CohenMurray/SRAD-Telemetry-PCB/PCB/Telemetry PCB V2/JLCPCB-order-config.png

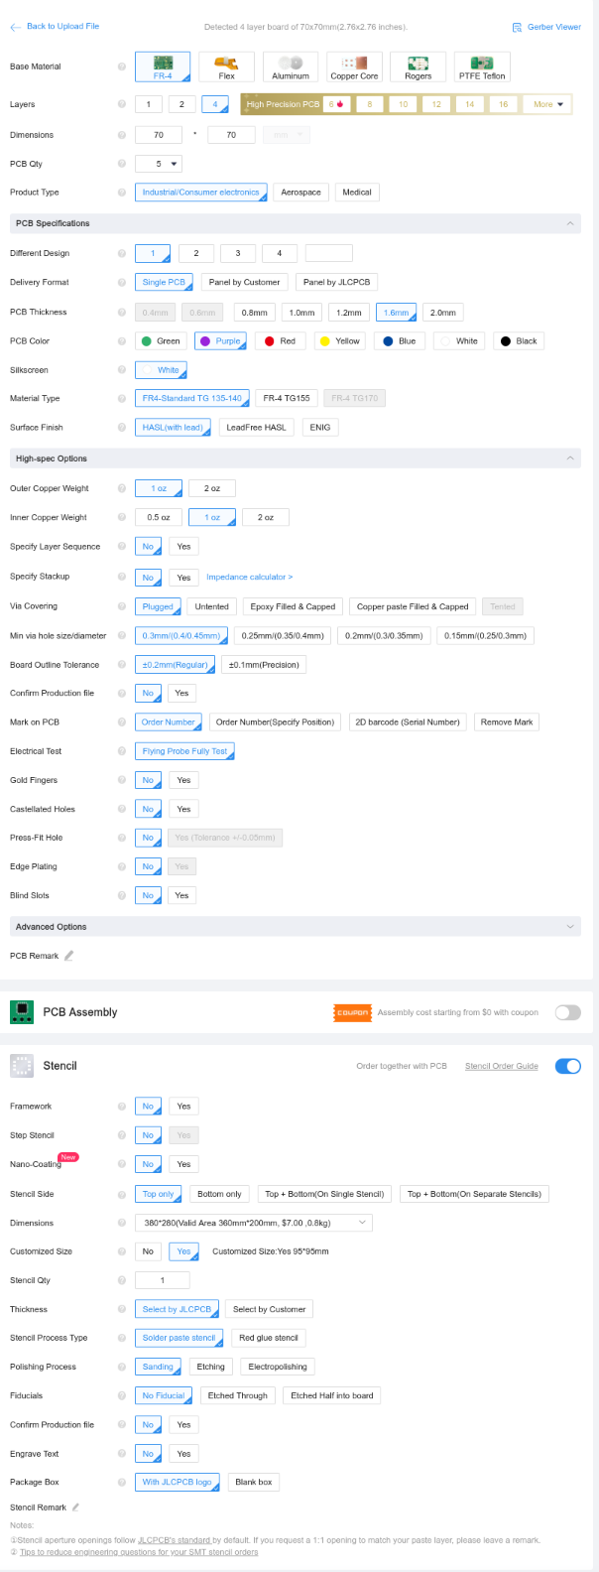
PCB/Telemetry PCB V2/JLCPCB-order-config.png
