CohenMurray/SRAD-Telemetry-PCB/KiCad Libraries/E22-900M30S/E22-900M30S.step

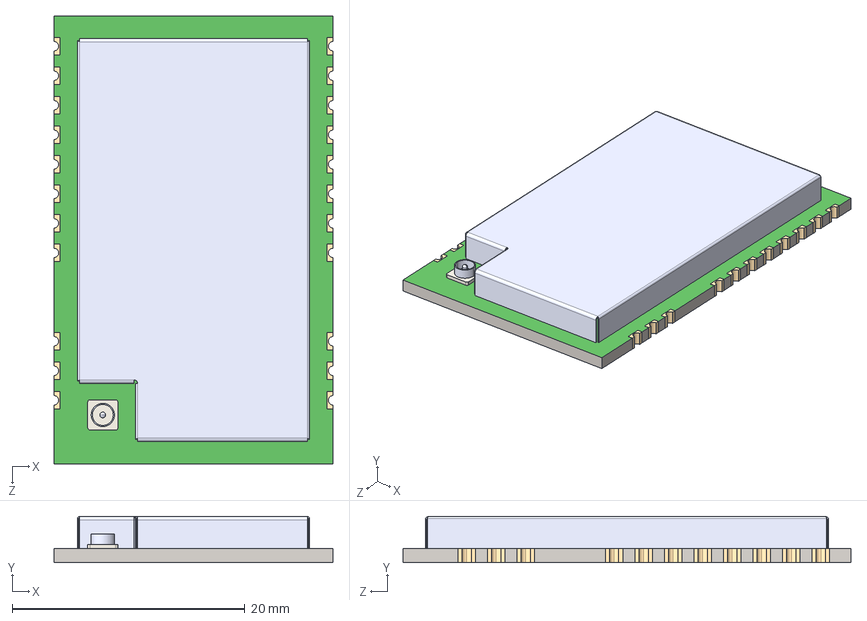
[picture p2: CAD file, 2024-10-28]
KiCad Libraries/E22-900M30S/E22-900M30S.step
24.0 x 3.97 x 38.5 mm
