CohenMurray/SRAD-Telemetry-PCB/KiCad Libraries/E22-900M33S/E22-900M22S.step

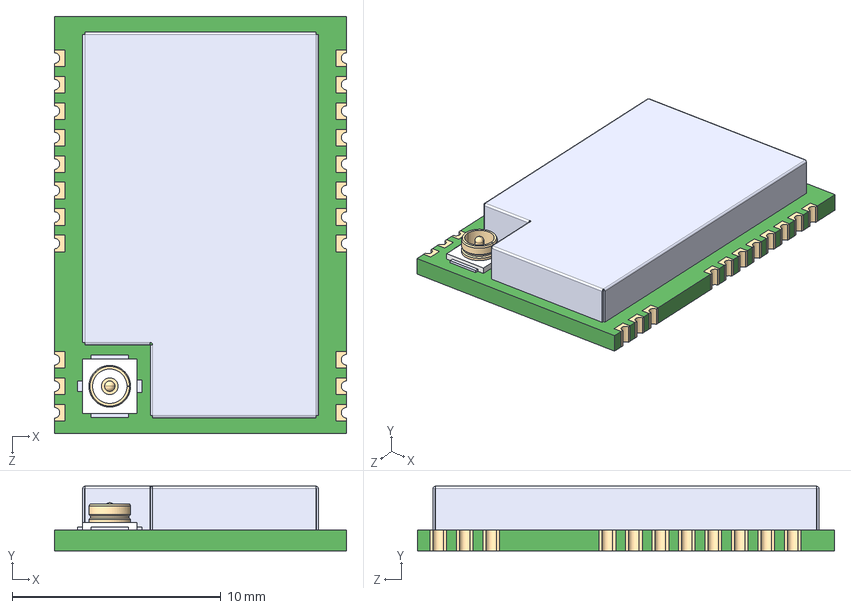
[picture p3: CAD file, 2024-10-25]
KiCad Libraries/E22-900M33S/E22-900M22S.step
14.0 x 3.10 x 20.0 mm
