CohenMurray/SRAD-Telemetry-PCB/KiCad Libraries/ECS_250_10_30B_CKM_TR/ECS-250-10-30B-CKM-TR.step

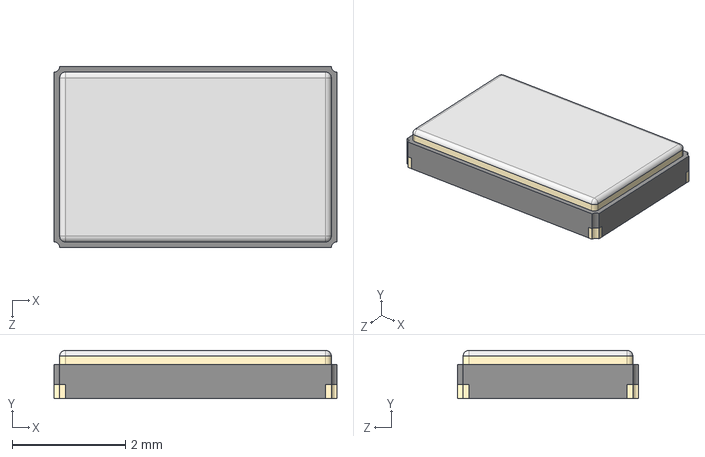
[picture p4: CAD file, 2024-11-11]
KiCad Libraries/ECS_250_10_30B_CKM_TR/ECS-250-10-30B-CKM-TR.step
5.00 x 0.85 x 3.20 mm
