CohenMurray/SRAD-Telemetry-PCB/KiCad Libraries/ECS__327_12_5_34RR_TR/ECS-.327-12.5-34RR-TR.step

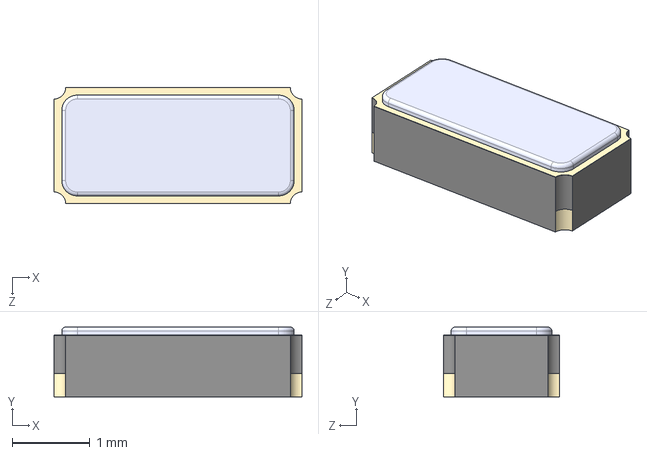
[picture p5: CAD file, 2024-11-11]
KiCad Libraries/ECS__327_12_5_34RR_TR/ECS-.327-12.5-34RR-TR.step
3.20 x 0.9 x 1.50 mm
