CohenMurray/SRAD-Telemetry-PCB/KiCad Libraries/LQH3NPN2R2MMEL/LQH3NPN2R2MMEL.step

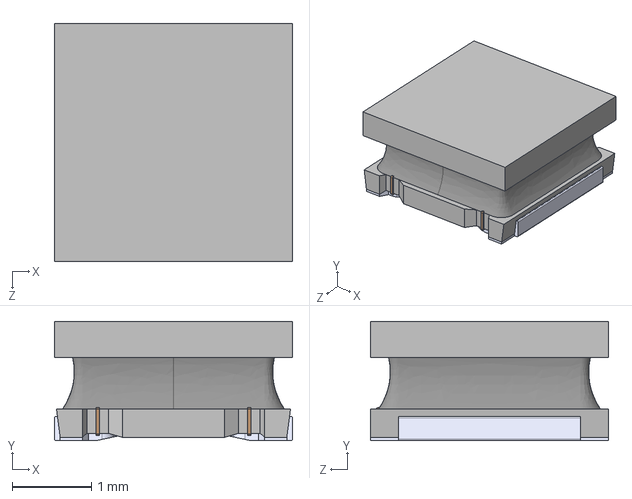
[picture p6: CAD file, 2025-09-01]
KiCad Libraries/LQH3NPN2R2MMEL/LQH3NPN2R2MMEL.step
3.00 x 1.50 x 3.00 mm
