CohenMurray/SRAD-Telemetry-PCB/PCB/Sending Pebble/Sending Pebble/Sending Pebble.kicad_pcb

## KiCad design PCB/Sending Pebble/Sending Pebble/Sending Pebble.kicad_pcb (2025-10-25)

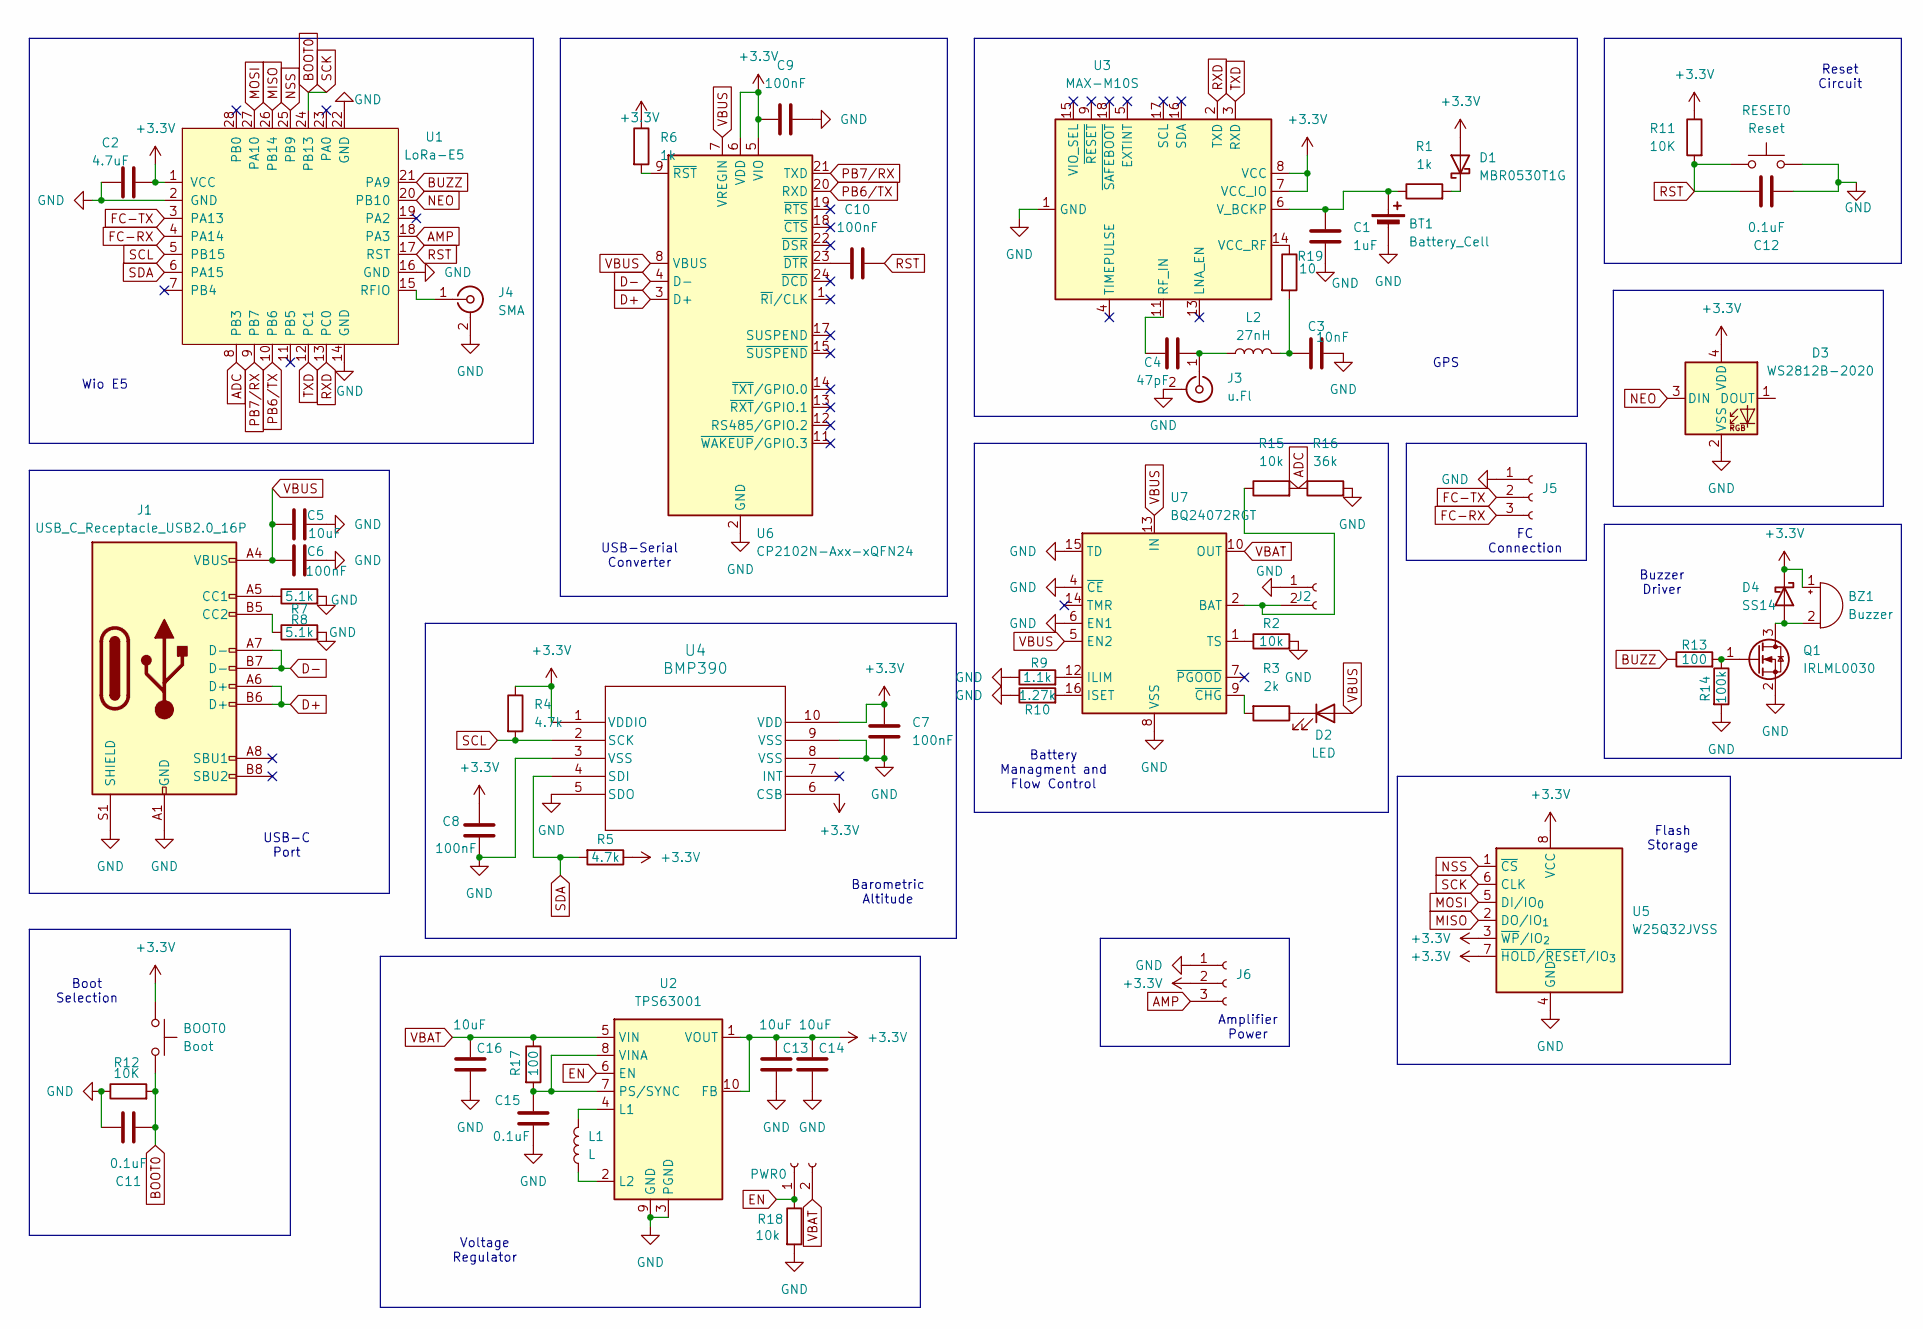
[picture p7: schematic Sending Pebble.kicad_sch, Sending Pebble v1]

Parts:
BOOT0: Boot; SW_SPST_PTS810
BT1: Battery_Cell; BatteryHolder_Seiko_MS621F
BZ1: Buzzer; MagneticBuzzer_PUI_SMT-1028-T-2-R
C1: 1uF; C_0603_1608Metric
C2: 4.7uF; C_0603_1608Metric
C3: 10nF; C_0402_1005Metric
C4: 47pF; C_0402_1005Metric
C5, C13, C14, C16: 10uF; C_0603_1608Metric
C6, C7, C8, C9, C10: 100nF; C_0603_1608Metric
C11, C12, C15: 0.1uF; C_0603_1608Metric
D1: MBR0530T1G; D_SOD-123
D2: LED; LED_0603_1608Metric
D3: WS2812B-2020; LED_WS2812B-2020_PLCC4_2.0x2.0mm
D4: SS14; D_SMA
J1: USB_C_Receptacle_USB2.0_16P; USB_C_Receptacle_HCTL_HC-TYPE-C-16P-01A
J2: Conn_01x02_Socket; JST_PH_S2B-PH-SM4-TB_1x02-1MP_P2.00mm_Horizontal
J3: u.Fl; U.FL_Hirose_U.FL-R-SMT-1_Vertical
J4: SMA; SMA_Amphenol_132289_EdgeMount
J5: Conn_01x03_Socket; JST_XH_B3B-XH-AM_1x03_P2.50mm_Vertical
J6: Conn_01x03_Socket; PinHeader_1x03_P2.54mm_Vertical
L1: L; IND_LQH3NPN2R2MMEL
L2: 27nH; C_0402_1005Metric
PWR0: Conn_01x02_Socket; PinSocket_1x02_P2.54mm_Vertical
Q1: IRLML0030; SOT-23
R1, R6: 1k; R_0603_1608Metric
R2, R15, R18: 10k; R_0603_1608Metric
R3: 2k; R_0603_1608Metric
R4, R5: 4.7k; R_0603_1608Metric
R7, R8: 5.1k; R_0603_1608Metric
R9: 1.1k; R_0603_1608Metric
R10: 1.27k; R_0603_1608Metric
R11, R12: 10K; R_0603_1608Metric
R13, R17: 100; R_0603_1608Metric
R14: 100k; R_0603_1608Metric
R16: 36k; R_0603_1608Metric
R19: 10; C_0402_1005Metric
RESET0: Reset; SW_SPST_PTS810
U1: LoRa-E5
U2: TPS63001; Texas_DRC0010J_ThermalVias
U3: MAX-M10S; ublox_MAX
U4: BMP390; 10LGA_2X2X0p75_BOS
U5: W25Q32JVSS; SOIC-8_5.3x5.3mm_P1.27mm
U6: CP2102N-Axx-xQFN24; QFN-24-1EP_4x4mm_P0.5mm_EP2.6x2.6mm
U7: BQ24072RGT; VQFN-16-1EP_3x3mm_P0.5mm_EP1.6x1.6mm

Connections:
+3.3V: BOOT0.1, BZ1.1 (+), C2.2, C7.1, C8.1, C9.1, C13.1, C14.1, D1.2 (A), D3.4 (VDD), D4.1 (K), J6.2, R4.1, R5.1, R6.1, R11.1, U1.1 (VCC), U2.1 (VOUT), U2.10 (FB), U3.7 (VCC_IO), U3.8 (VCC), U4.1 (VDDIO), U4.6 (CSB), U4.10 (VDD), U5.3 (~WP/IO_{2}), U5.7 (~HOLD/~RESET/IO_{3}), U5.8 (VCC), U6.5 (VIO), U6.6 (VDD)
ADC: R15.2, R16.1, U1.8 (PB3)
AMP: J6.3, U1.18 (PA3)
BOOT0: BOOT0.2, C11.2, R12.2, U1.24 (PB13~), U5.6 (CLK)
BUZZ: R13.1, U1.21 (PA9)
D+: J1.A6 (D+), J1.B6 (D+), U6.3 (D+)
D-: J1.A7 (D-), J1.B7 (D-), U6.4 (D-)
EN: PWR0.1, R18.1, U2.6 (EN)
FC-RX: J5.3, U1.4 (PA14)
FC-TX: J5.2, U1.3 (PA13)
GND: BT1.2 (-), C1.2, C2.1, C3.2, C5.2, C6.2, C7.2, C8.2, C9.2, C11.1, C12.2, C13.2, C14.2, C15.2, C16.2, D3.2 (VSS), J1.A1 (GND), J1.A12 (GND), J1.B1 (GND), J1.B12 (GND), J1.S1 (SHIELD), J2.1, J3.2 (Ext), J4.2 (Ext), J5.1, J6.1, Q1.2 (S), R2.2, R7.2, R8.2, R9.1, R10.1, R12.1, R14.2, R16.2, R18.2, RESET0.2, U1.2 (GND), U1.14 (GND), U1.16 (GND), U1.22 (GND), U2.3 (PGND), U2.9 (GND), U2.11 (PGND), U3.1 (GND), U3.10 (GND), U3.12 (GND), U4.3 (VSS), U4.5 (SDO), U4.8 (VSS), U4.9 (VSS), U5.4 (GND), U6.2 (GND), U6.25 (GND), U7.4 (~CE), U7.6 (EN1), U7.8 (VSS), U7.15 (TD), U7.17 (VSS)
MISO: U1.26 (PB14), U5.2 (DO/IO_{1})
MOSI: U1.27 (PA10), U5.5 (DI/IO_{0})
NEO: D3.3 (DIN), U1.20 (PB10)
NSS: U1.25 (PB9), U5.1 (~CS)
unnamed: BT1.1 (+), C1.1, R1.1, U3.6 (V_BCKP)
unnamed: BZ1.2 (-), D4.2 (A), Q1.3 (D)
unnamed: C3.1, L2.2, R19.2
unnamed: D1.1 (K), R1.2
unnamed: D2.1 (K), R3.1
unnamed: J1.A5 (CC1), R7.1
unnamed: J1.B5 (CC2), R8.1
unnamed: J2.2, R15.1, U7.2 (BAT), U7.3 (BAT)
unnamed: C4.2, J3.1 (In), L2.1
unnamed: J4.1 (In), U1.15 (RFIO)
unnamed: Q1.1 (G), R13.2, R14.1
unnamed: L1.2, U2.4 (L1)
unnamed: L1.1, U2.2 (L2)
unnamed: C15.1, R17.2, U2.7 (PS/SYNC), U2.8 (VINA)
unnamed: C4.1, U3.11 (RF_IN)
unnamed: R19.1, U3.14 (VCC_RF)
unnamed: C10.1, U6.23 (~DTR)
unnamed: R6.2, U6.9 (~RST)
unnamed: R9.2, U7.12 (ILIM)
unnamed: R10.2, U7.16 (ISET)
unnamed: R2.1, U7.1 (TS)
unnamed: R3.2, U7.9 (~CHG)
PB6/TX: U1.10 (PB6), U6.20 (RXD)
PB7/RX: U1.9 (PB7), U6.21 (TXD)
RST: C10.2, C12.1, R11.2, RESET0.1, U1.17 (RST)
RXD: U1.13 (PC0), U3.2 (TXD)
SCL: R4.2, U1.5 (PB15), U4.2 (SCK)
SDA: R5.2, U1.6 (PA15), U4.4 (SDI)
TXD: U1.12 (PC1), U3.3 (RXD)
VBAT: C16.1, PWR0.2, R17.1, U2.5 (VIN), U7.10 (OUT), U7.11 (OUT)
VBUS: C5.1, C6.1, D2.2 (A), J1.A4 (VBUS), J1.A9 (VBUS), J1.B4 (VBUS), J1.B9 (VBUS), U6.7 (VREGIN), U6.8 (VBUS), U7.5 (EN2), U7.13 (IN)

Notes on the sheet:
GPS
FC Connection
Battery Managment and Flow Control
USB-C Port
Flash Storage
Amplifier Power
Voltage Regulator
USB-Serial Converter
Barometric Altitude
Reset Circuit
Buzzer Driver
Wio E5
Boot Selection

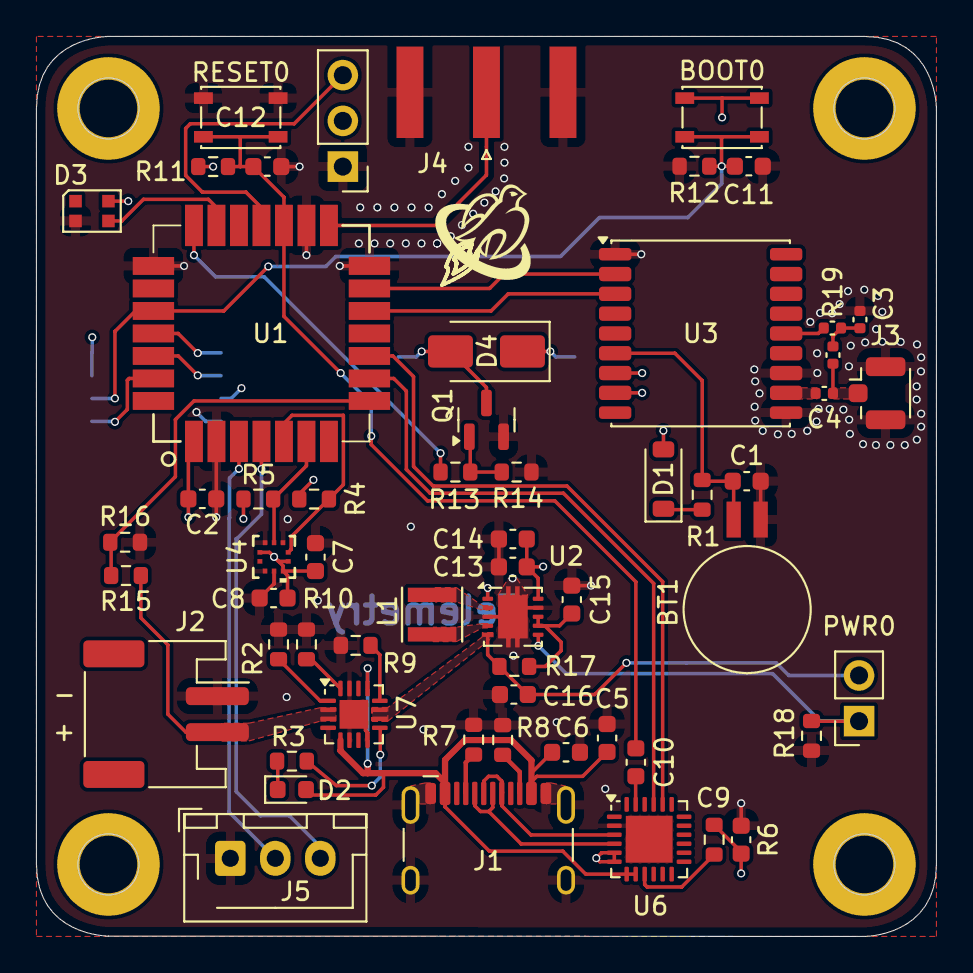
[picture p8: board Sending Pebble.kicad_pcb from above]

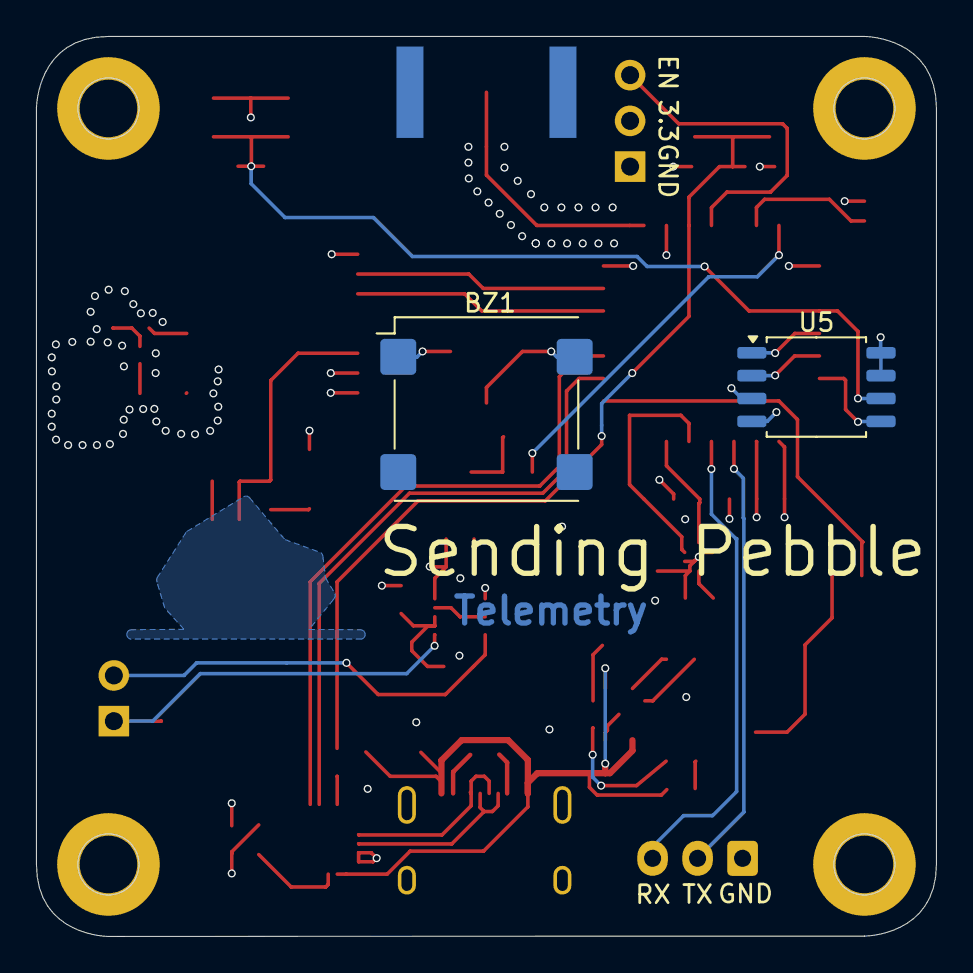
[picture p9: board Sending Pebble.kicad_pcb from below]

Board: 4 copper layers, 50.0 x 50.0 mm, 60 parts (2 on the bottom side), 46 nets.
