CohenMurray/SRAD-Telemetry-PCB/PCB/Telemetry PCB V2/Telemetry PCB V2.kicad_pcb

## KiCad design PCB/Telemetry PCB V2/Telemetry PCB V2.kicad_pcb (2025-07-25)

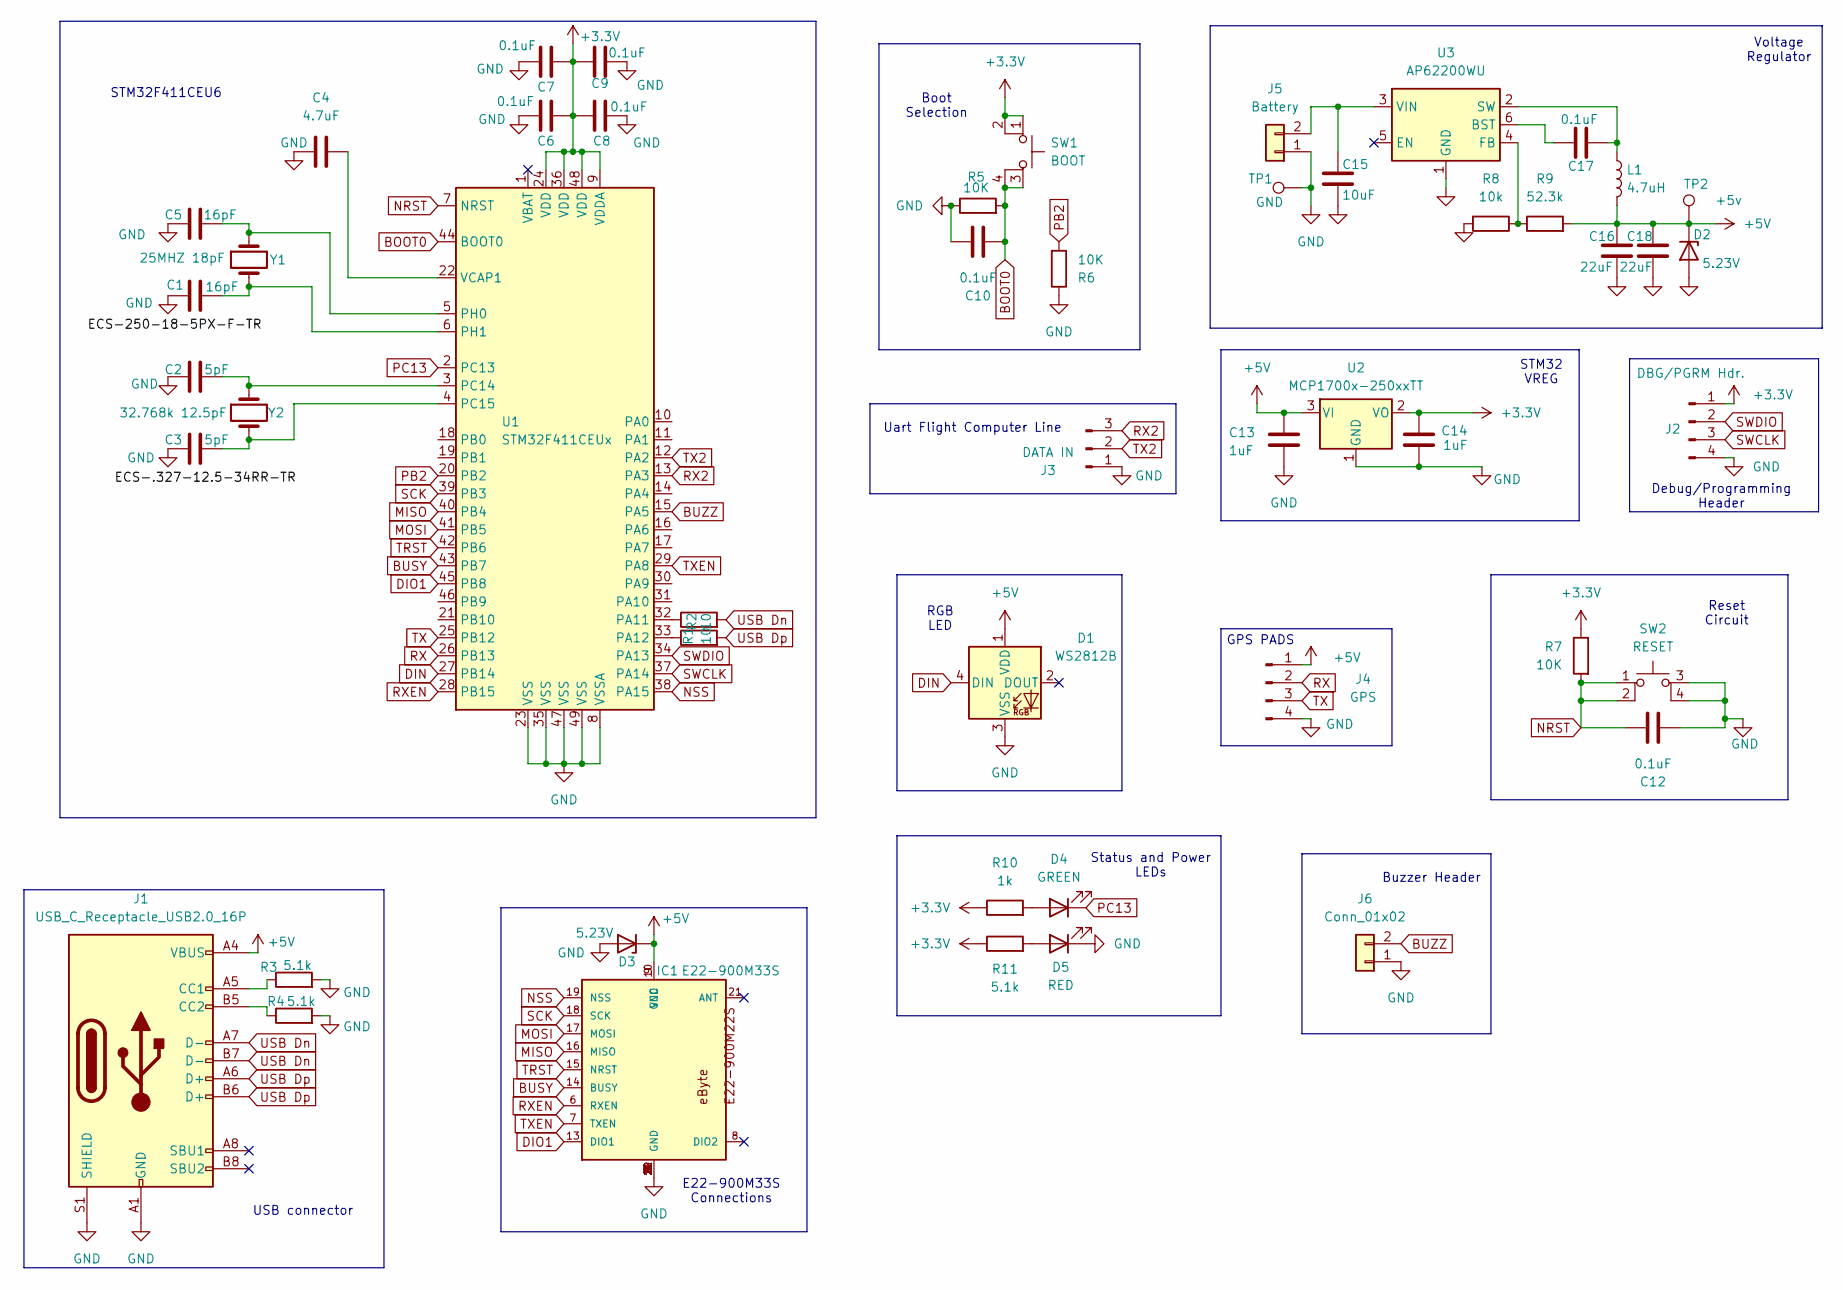
[picture p10: schematic Telemetry PCB V2.kicad_sch]

Parts:
C1, C5: 16pF; C_1206_3216Metric_Pad1.33x1.80mm_HandSolder
C2, C3: 5pF; C_0603_1608Metric_Pad1.08x0.95mm_HandSolder
C4: 4.7uF; C_1206_3216Metric_Pad1.33x1.80mm_HandSolder
C6, C7, C8, C9: 0.1uF; C_0603_1608Metric_Pad1.08x0.95mm_HandSolder
C10, C12, C17: 0.1uF; C_1206_3216Metric_Pad1.33x1.80mm_HandSolder
C13, C14: 1uF; C_1206_3216Metric_Pad1.33x1.80mm_HandSolder
C15: 10uF; C_1206_3216Metric_Pad1.33x1.80mm_HandSolder
C16, C18: 22uF; C_1206_3216Metric_Pad1.33x1.80mm_HandSolder
D1: WS2812B; LED_WS2812B_PLCC4_5.0x5.0mm_P3.2mm
D2, D3: 5.23V; CR_1C-G3&slash_H_VIS
D4: GREEN; LED_1206_3216Metric
D5: RED; LED_1206_3216Metric
IC1: E22-900M33S; XCVR_E22-900M33S
J1: USB_C_Receptacle_USB2.0_16P; USB_C_Receptacle_HCTL_HC-TYPE-C-16P-01A (SMALLER PADS)
J2: DBG/PGRM Hdr.; PinHeader_1x04_P2.54mm_Vertical
J3: DATA IN; JST_XH_B3B-XH-A_1x03_P2.50mm_Vertical
J4: GPS; PinHeader_1x04_P2.54mm_Vertical
J5: Battery; JST_XH_B2B-XH-A_1x02_P2.50mm_Vertical
J6: Conn_01x02; JST_XH_B2B-XH-A_1x02_P2.50mm_Vertical
L1: 4.7uH; IND_SRN5040_BRN
R1, R2: 10; C_1206_3216Metric_Pad1.33x1.80mm_HandSolder
R3, R4: 5.1k; C_1206_3216Metric_Pad1.33x1.80mm_HandSolder
R5, R6, R7: 10K; R_1206_3216Metric_Pad1.30x1.75mm_HandSolder
R8: 10k; R_1206_3216Metric_Pad1.30x1.75mm_HandSolder
R9: 52.3k; R_1206_3216Metric_Pad1.30x1.75mm_HandSolder
R10: 1k; R_1206_3216Metric
R11: 5.1k; R_1206_3216Metric
SW1: BOOT; SON4_PTS526 SM15 SMTR2 LFS_CNK
SW2: RESET; SON4_PTS526 SM15 SMTR2 LFS_CNK
TP1: GND; TestPoint_Loop_D1.80mm_Drill1.0mm_Beaded
TP2: +5v; TestPoint_Loop_D1.80mm_Drill1.0mm_Beaded
U1: STM32F411CEUx; QFN-48-1EP_7x7mm_P0.5mm_EP5.6x5.6mm
U2: MCP1700x-250xxTT; SOT-23
U3: AP62200WU; TSOT-23-6
Y1: 25MHZ 18pF; Crystal_SMD_HC49-SD_HandSoldering
Y2: 32.768k 12.5pF; XTAL_ECS-.327-12.5-34RR-TR

Connections:
+3.3V: C6.2, C7.1, C8.1, C9.2, C14.1, J2.1, R7.1, R10.1, R11.1, SW1.1, SW1.2, U1.9 (VDDA), U1.24 (VDD), U1.36 (VDD), U1.48 (VDD), U2.2 (VO)
+5V: C13.1, C16.2, C18.2, D1.1 (VDD), D2.1 (K), D3.1 (K), IC1.9 (VCC), IC1.10 (GND), J1.A4 (VBUS), J1.A9 (VBUS), J1.B4 (VBUS), J1.B9 (VBUS), J4.1, L1.2, R9.2, TP2.1, U2.3 (VI)
BOOT0: C10.2, R5.2, SW1.3 (A), SW1.4 (K), U1.44 (BOOT0)
BUSY: IC1.14 (BUSY), U1.43 (PB7)
BUZZ: J6.2, U1.15 (PA5)
DIN: D1.4 (DIN), U1.27 (PB14)
DIO1: IC1.13 (DIO1), U1.45 (PB8)
GND: C1.1, C2.1, C3.2, C4.1, C5.1, C6.1, C7.2, C8.2, C9.1, C10.1, C12.2, C13.2, C14.2, C15.2, C16.1, C18.1, D1.3 (VSS), D2.2 (A), D3.2 (A), D5.1 (K), IC1.1 (GND), IC1.2 (GND), IC1.3 (GND), IC1.4 (GND), IC1.5 (GND), IC1.11 (GND), IC1.12 (GND), IC1.20 (GND), IC1.22 (GND), J1.A1 (GND), J1.A12 (GND), J1.B1 (GND), J1.B12 (GND), J1.S1 (SHIELD), J2.4, J3.1, J4.4, J5.1, J6.1, R3.2, R4.2, R5.1, R6.1, R8.2, SW2.3 (A), SW2.4 (K), TP1.1, U1.8 (VSSA), U1.23 (VSS), U1.35 (VSS), U1.47 (VSS), U1.49 (VSS), U2.1 (GND), U3.1 (GND)
MISO: IC1.16 (MISO), U1.40 (PB4)
MOSI: IC1.17 (MOSI), U1.41 (PB5)
NRST: C12.1, R7.2, SW2.1, SW2.2, U1.7 (NRST)
NSS: IC1.19 (NSS), U1.38 (PA15)
unnamed: D4.2 (A), R10.2
unnamed: D5.2 (A), R11.2
unnamed: J1.A5 (CC1), R3.1
unnamed: J1.B5 (CC2), R4.1
unnamed: C15.1, J5.2, U3.3 (VIN)
unnamed: R1.1, U1.32 (PA11)
unnamed: R2.1, U1.33 (PA12)
unnamed: C2.2, U1.3 (PC14), Y2.1
unnamed: C3.1, U1.4 (PC15), Y2.2
unnamed: C5.2, U1.5 (PH0), Y1.1
unnamed: C1.2, U1.6 (PH1), Y1.2
unnamed: C4.2, U1.22 (VCAP1)
unnamed: C17.1, U3.6 (BST)
unnamed: R8.1, R9.1, U3.4 (FB)
unnamed: C17.2, L1.1, U3.2 (SW)
PB2: R6.2, U1.20 (PB2)
PC13: D4.1 (K), U1.2 (PC13)
RX: J4.2, U1.26 (PB13)
RX2: J3.3, U1.13 (PA3)
RXEN: IC1.6 (RXEN), U1.28 (PB15)
SCK: IC1.18 (SCK), U1.39 (PB3)
SWCLK: J2.3, U1.37 (PA14)
SWDIO: J2.2, U1.34 (PA13)
TRST: IC1.15 (NRST), U1.42 (PB6)
TX: J4.3, U1.25 (PB12)
TX2: J3.2, U1.12 (PA2)
TXEN: IC1.7 (TXEN), U1.29 (PA8)
USB Dn: J1.A7 (D-), J1.B7 (D-), R1.2
USB Dp: J1.A6 (D+), J1.B6 (D+), R2.2

Notes on the sheet:
Boot Selection
Reset Circuit
GPS PADS
STM32 VREG
E22-900M33S Connections
Debug/Programming Header
Buzzer Header
Status and Power LEDs
USB connector
Uart Flight Computer Line
Voltage Regulator
STM32F411CEU6
RGB LED

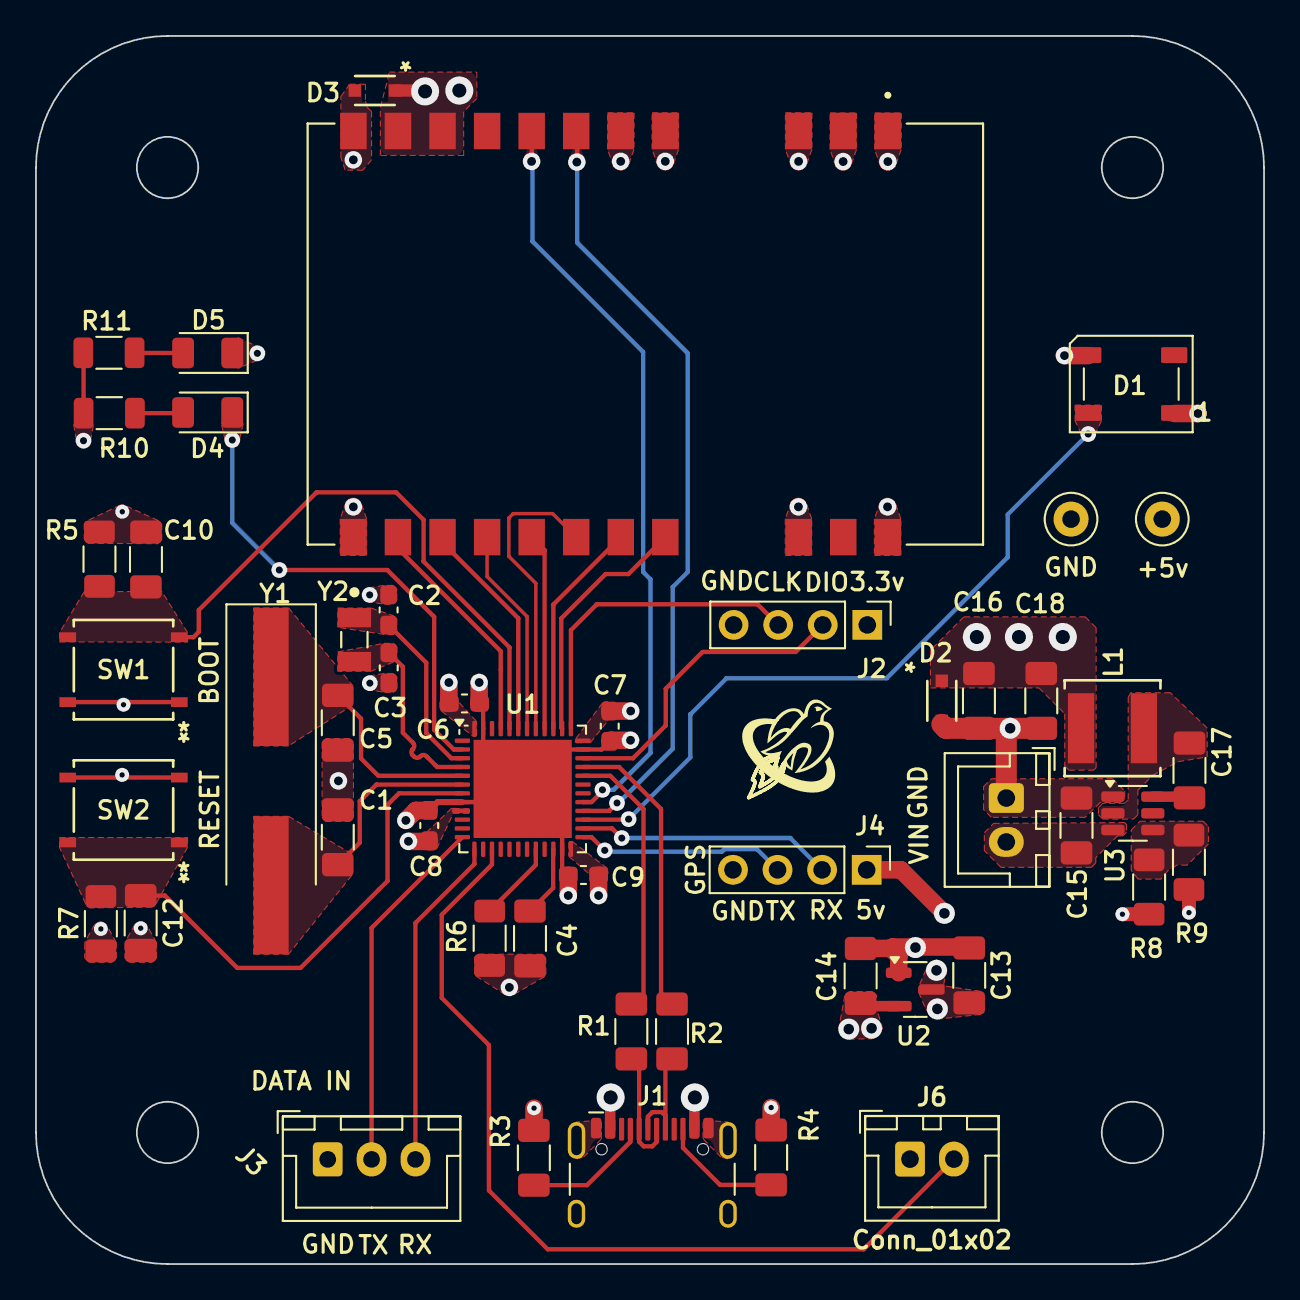
[picture p11: board Telemetry PCB V2.kicad_pcb from above]

Board: 4 copper layers, 70.0 x 70.0 mm, 50 parts (0 on the bottom side), 41 nets.
