CohenMurray/SRAD-Telemetry-PCB/PCB/Telemetry PCB/Telemetry PCB.kicad_pcb

## KiCad design PCB/Telemetry PCB/Telemetry PCB.kicad_pcb (2024-11-17, an earlier design)

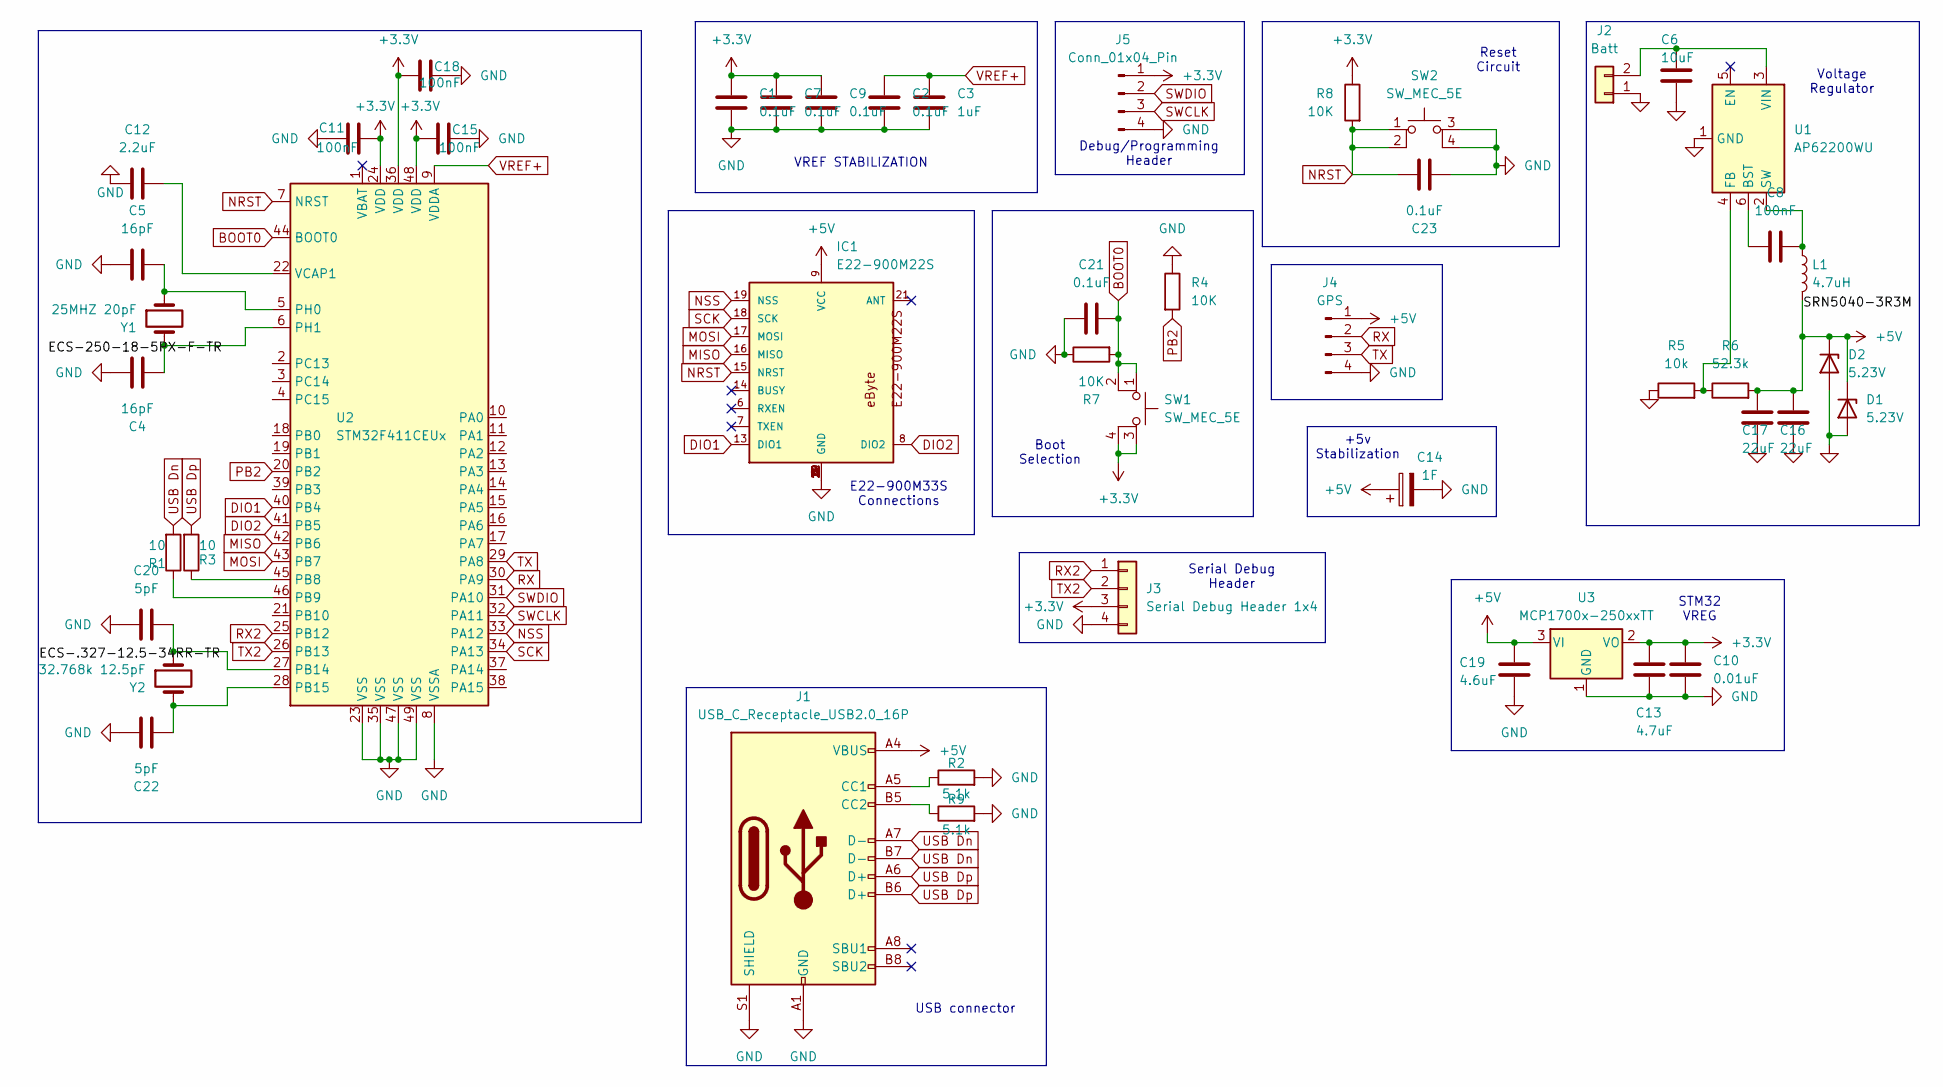
[picture p12: schematic Telemetry PCB.kicad_sch]

Parts:
C1, C2, C7, C9, C21, C23: 0.1uF; C_1206_3216Metric_Pad1.33x1.80mm_HandSolder
C3: 1uF; C_1206_3216Metric_Pad1.33x1.80mm_HandSolder
C4, C5: 16pF; C_1206_3216Metric_Pad1.33x1.80mm_HandSolder
C6: 10uF; C_1206_3216Metric_Pad1.33x1.80mm_HandSolder
C8, C11, C15, C18: 100nF; C_1206_3216Metric_Pad1.33x1.80mm_HandSolder
C10: 0.01uF; C_1206_3216Metric_Pad1.33x1.80mm_HandSolder
C12: 2.2uF; C_1206_3216Metric_Pad1.33x1.80mm_HandSolder
C13: 4.7uF; C_1206_3216Metric_Pad1.33x1.80mm_HandSolder
C14: 1F; C_Radial_D10.0mm_H20.0mm_P5.00mm
C16, C17: 22uF; C_1206_3216Metric_Pad1.33x1.80mm_HandSolder
C19: 4.6uF; C_1206_3216Metric_Pad1.33x1.80mm_HandSolder
C20, C22: 5pF; C_1206_3216Metric_Pad1.33x1.80mm_HandSolder
D1, D2: 5.23V; CR_1C-G3&slash_H_VIS
IC1: E22-900M22S; XCVR_E22-900M30S
J1: USB_C_Receptacle_USB2.0_16P; USB_C_Receptacle_GCT_USB4105-xx-A_16P_TopMnt_Horizontal
J2: Batt; PinHeader_1x02_P2.54mm_Vertical
J3: Serial Debug Header 1x4; PinHeader_1x04_P2.54mm_Vertical
J4: GPS; PinHeader_1x04_P2.54mm_Vertical
J5: Conn_01x04_Pin; PinHeader_1x04_P2.54mm_Vertical
L1: 4.7uH; IND_SRN5040_BRN
R1, R3: 10; C_1206_3216Metric_Pad1.33x1.80mm_HandSolder
R2, R9: 5.1k; C_1206_3216Metric_Pad1.33x1.80mm_HandSolder
R4, R7, R8: 10K; R_1206_3216Metric_Pad1.30x1.75mm_HandSolder
R5: 10k; R_1206_3216Metric_Pad1.30x1.75mm_HandSolder
R6: 52.3k; R_1206_3216Metric_Pad1.30x1.75mm_HandSolder
SW1, SW2: SW_MEC_5E; SON4_PTS526 SM15 SMTR2 LFS_CNK
U1: AP62200WU; TSOT-23-6
U2: STM32F411CEUx; QFN-48-1EP_7x7mm_P0.5mm_EP5.6x5.6mm
U3: MCP1700x-250xxTT; SOT-23
Y1: 25MHZ 20pF; Crystal_SMD_HC49-SD_HandSoldering
Y2: 32.768k 12.5pF; XTAL_ECS-.327-12.5-34RR-TR

Connections:
+3.3V: C1.1, C7.1, C9.1, C10.1, C11.2, C13.1, C15.1, C18.1, J3.3, J5.1, R8.1, SW1.3 (A), SW1.4 (K), U2.24 (VDD), U2.36 (VDD), U2.48 (VDD), U3.2 (VO)
+5V: C14.1, C16.2, C17.2, C19.1, D1.1 (K), D2.1 (K), IC1.9 (VCC), J1.A4 (VBUS), J1.A9 (VBUS), J1.B4 (VBUS), J1.B9 (VBUS), J4.1, L1.2, R6.2, U3.3 (VI)
BOOT0: C21.2, R7.2, SW1.1, SW1.2, U2.44 (BOOT0)
DIO1: IC1.13 (DIO1), U2.40 (PB4)
DIO2: IC1.8 (DIO2), U2.41 (PB5)
GND: C1.2, C2.2, C3.2, C4.1, C5.1, C6.2, C7.2, C9.2, C10.2, C11.1, C12.1, C13.2, C14.2, C15.2, C16.1, C17.1, C18.2, C19.2, C20.1, C21.1, C22.2, C23.2, D1.2 (A), D2.2 (A), IC1.1 (GND), IC1.2 (GND), IC1.3 (GND), IC1.4 (GND), IC1.5 (GND), IC1.10 (GND), IC1.11 (GND), IC1.12 (GND), IC1.20 (GND), IC1.22 (GND), J1.A1 (GND), J1.A12 (GND), J1.B1 (GND), J1.B12 (GND), J1.S1 (SHIELD), J2.1, J3.4, J4.4, J5.4, R2.2, R4.1, R5.1, R7.1, R9.2, SW2.3 (A), SW2.4 (K), U1.1 (GND), U2.8 (VSSA), U2.23 (VSS), U2.35 (VSS), U2.47 (VSS), U2.49 (VSS), U3.1 (GND)
MISO: IC1.16 (MISO), U2.42 (PB6)
MOSI: IC1.17 (MOSI), U2.43 (PB7)
NRST: C23.1, IC1.15 (NRST), R8.2, SW2.1, SW2.2, U2.7 (NRST)
NSS: IC1.19 (NSS), U2.33 (PA12)
unnamed: J1.A5 (CC1), R2.1
unnamed: J1.B5 (CC2), R9.1
unnamed: C6.1, J2.2, U1.3 (VIN)
unnamed: C8.1, U1.6 (BST)
unnamed: R5.2, R6.1, U1.4 (FB)
unnamed: C8.2, L1.1, U1.2 (SW)
unnamed: R3.1, U2.45 (PB8)
unnamed: R1.1, U2.46 (PB9)
unnamed: C20.2, U2.27 (PB14), Y2.1
unnamed: C22.1, U2.28 (PB15), Y2.2
unnamed: C5.2, U2.5 (PH0), Y1.1
unnamed: C4.2, U2.6 (PH1), Y1.2
unnamed: C12.2, U2.22 (VCAP1)
PB2: R4.2, U2.20 (PB2)
RX: J4.2, U2.30 (PA9)
RX2: J3.1, U2.25 (PB12)
SCK: IC1.18 (SCK), U2.34 (PA13)
SWCLK: J5.3, U2.32 (PA11)
SWDIO: J5.2, U2.31 (PA10)
TX: J4.3, U2.29 (PA8)
TX2: J3.2, U2.26 (PB13)
USB Dn: J1.A7 (D-), J1.B7 (D-), R1.2
USB Dp: J1.A6 (D+), J1.B6 (D+), R3.2
VREF+: C2.1, C3.1, U2.9 (VDDA)

Notes on the sheet:
Boot Selection
Reset Circuit
STM32 VREG
E22-900M33S Connections
Debug/Programming Header
USB connector
VREF STABILIZATION
Serial Debug Header
Voltage Regulator
+5v Stabilization

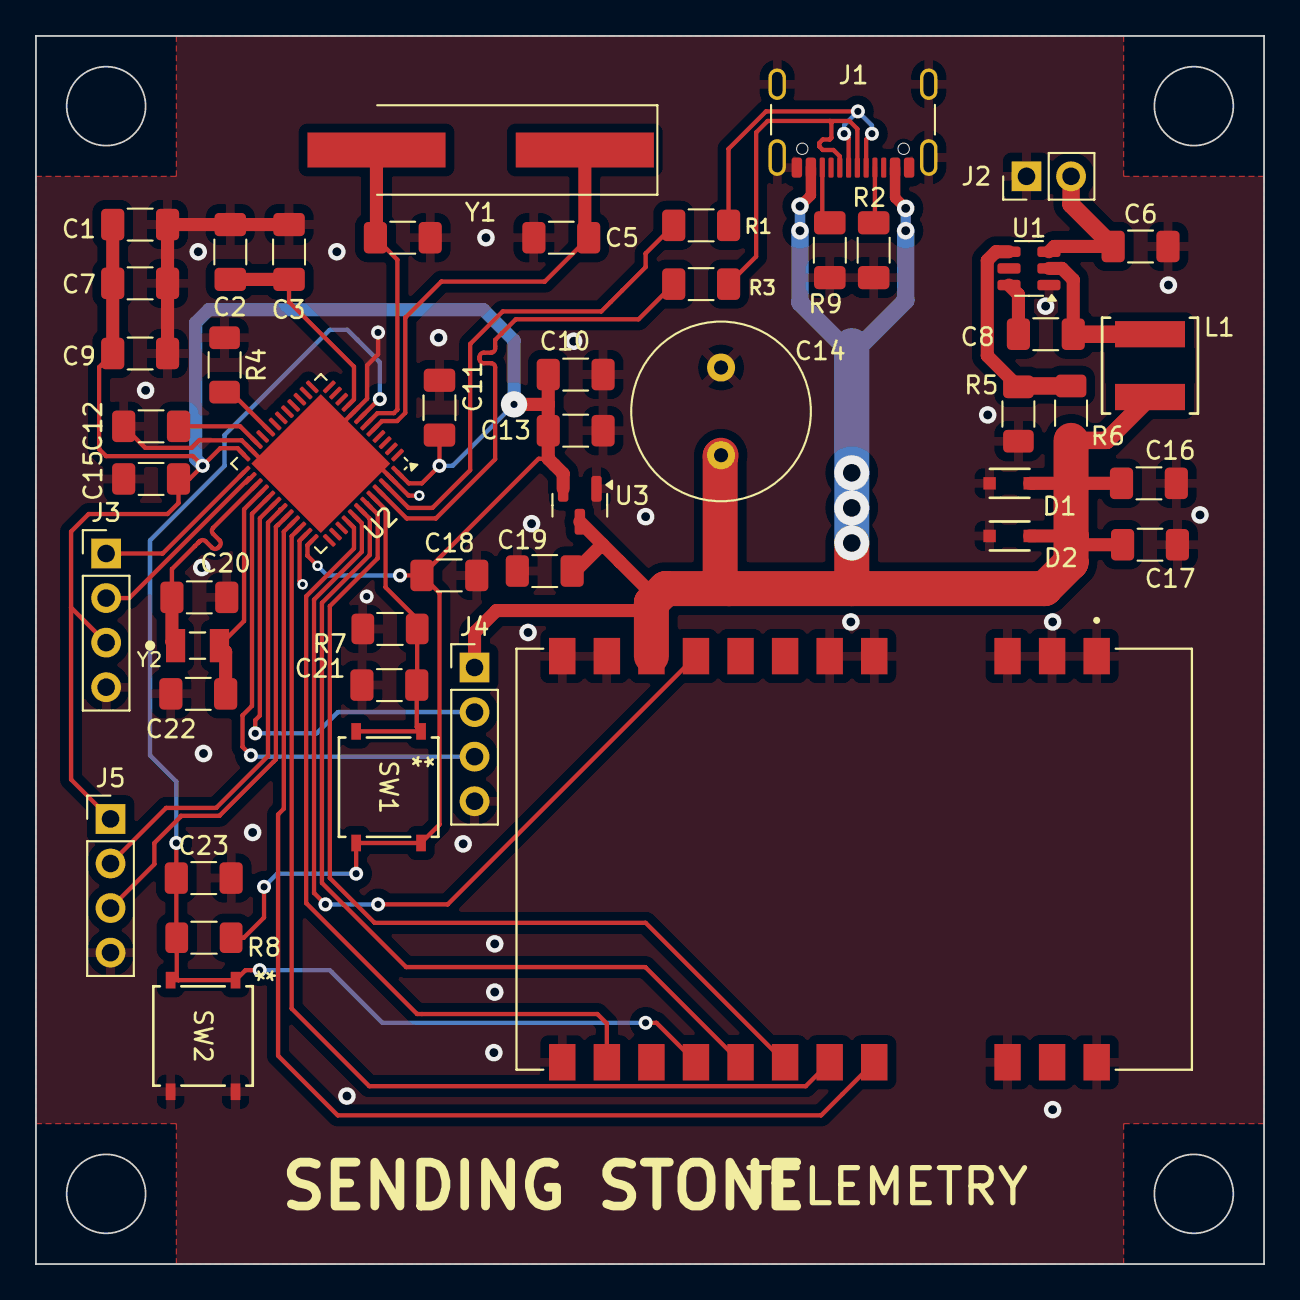
[picture p13: board Telemetry PCB.kicad_pcb from above]

Board: 2 copper layers, 70.0 x 70.0 mm, 48 parts (0 on the bottom side), 34 nets.
