CohenMurray/SRAD-Telemetry-PCB/(commit log)

2024-10-24 Initial document creation and schematic start
    [Telemetry PCB.kicad_pcb, Telemetry PCB.kicad_sch]
2024-10-25 Boot, reset and VREF circuits and programming header added
    [Telemetry PCB.kicad_sch]
2024-10-25 E22-900M33s initial circuitry added
    [E22-900M22S.step, Telemetry PCB.kicad_sch]
2024-10-26 Added gps connection
    [Telemetry PCB.kicad_sch]
2024-10-28 Update e22-900m33s library and add gps connection to mcu
    e22-900m33s had wrong footprint library. Library has been updated to proper one.
    [E22-900M30S.step, Telemetry PCB.kicad_sch]
2024-10-31 Added buck converter circuit
    [Telemetry PCB.kicad_sch]
2024-10-31 Rewired vreg circuit
    [Telemetry PCB.kicad_sch]
2024-11-01 removed potentiometer and replaced with exact value resistors
    [Telemetry PCB.kicad_sch]
2024-11-02 added component values for vreg
    [Telemetry PCB.kicad_sch]
2024-11-07 added footprints
    [Telemetry PCB.kicad_sch]
2024-11-07 more footprints
    [Telemetry PCB.kicad_sch]
2024-11-07 changed switching regulator to 5v added 3.3v linear regulator
    [Telemetry PCB.kicad_sch]
2024-11-09 Added usb & footprints. Tweaked Crystals
    Changed Crystals and associated caps
    duplicated Zener diode
    added usb connection (moved dio1 & dio2 from PA11 & 12 to PB8 & 9)
    added footprints to all components
2024-11-11 see last push discription
    Last push did not work. see last push for description
    [ECS-.327-12.5-34RR-TR.step, ECS-250-10-30B-CKM-TR.step, Telemetry PCB.kicad_sch]
2024-11-12 First Board Prototype
    tweaked the filter caps for stm32. changed switches. and moved many pins around on the stm32 to ease trace routing. Created first board prototype
    [Telemetry PCB.kicad_pcb, Telemetry PCB.kicad_sch]
2024-11-12 Updated silkscreen and fixed front plane islands
    Updated silkscreen and fixed front plane islands
    [Telemetry PCB.kicad_pcb, Telemetry PCB.kicad_sch]
2024-11-12 reannotated based on board geometry
    reannotated based on board geometry
    [Telemetry PCB.kicad_pcb, Telemetry PCB.kicad_sch]
2024-11-14 Added missing Gnd trace on Stm32
    Added missing Gnd trace on Stm32
    [Telemetry PCB.kicad_pcb]
2024-11-17 Tweaked usb and data traces
    Tweaked usb board should be able to be powered by usb without catching fire
    I also moved some data traces away from each other and filled between them to lower their parasitic capacitance
    [Telemetry PCB.kicad_pcb, Telemetry PCB.kicad_sch]
2024-11-24 Updated E22 connections
    [Telemetry PCB.kicad_sch]
2024-12-20 Started work on SRAD Prototype V2
    Moved to a 4 layer PCB.
    Changed the value of the filter capacitors near the linear voltage regulator to better fit our use case.
    moved some of the IO pins around for routing reasons.
    [Telemetry PCB V2.kicad_pcb, Telemetry PCB V2.kicad_sch]
2024-12-30 Continued Layout for V2
    Continued to place components and layout for v2 board.
    [Telemetry PCB V2.kicad_pcb, Telemetry PCB V2.kicad_sch]
2025-01-09 continued work on v2
    Placed many polygon pads and moved various components around
    [Telemetry PCB V2.kicad_pcb]
2025-01-09 Work continues
    More pads + tinkered with Vias. Also reoriented the 32kHz crystal so that the load capacitors were between it and the MCU.
    [Telemetry PCB V2.kicad_pcb, Telemetry PCB V2.kicad_sch]
2025-01-19 changed power connector
    Changed power connector to JST-XH 2pin and moved some stuff a tiny bit
    [Telemetry PCB V2.kicad_pcb, Telemetry PCB V2.kicad_sch]
2025-01-19 added bolt clearance, moved switches
    added bolt clearance sections. I also moved the nrst switch because it has to connect to the transmitter and because its previous location was in the bolt clearance zone.
    [Telemetry PCB V2.kicad_pcb]
2025-01-19 corrected washer size
    [Telemetry PCB V2.kicad_pcb]
2025-01-19 Corrected spi and uart connections
    [Telemetry PCB V2.kicad_pcb, Telemetry PCB V2.kicad_sch]
2025-01-19 Pins that were wrong are now right
    Pins that were wrong are now right and also changed form 1206 capacitors to 0603 capacitors for the load capacitors on the low speed oscillator to reduce size for placement reasons.
    [Telemetry PCB V2.kicad_pcb, Telemetry PCB V2.kicad_sch]
2025-01-20 much progress
    Added power planes, edge cuts, and connected many components
    [Telemetry PCB V2.kicad_pcb]
2025-01-20 minor placement tweaks
    [Telemetry PCB V2.kicad_pcb]
2025-01-22 All connections made
    All components are now connected all the remains is tweaking a few connections that violate clearances and making the silk screen legible.
    [Telemetry PCB V2.kicad_pcb]
2025-01-22 minor fill tweaks
    [Telemetry PCB V2.kicad_pcb]
2025-01-24 Zero Errors, silkscreen warnings
    Zero errors remain all connections are made and within clearance. remaining warnings are about footprint libraries and silkscreen.
    [Telemetry PCB V2.kicad_pcb]
2025-01-25 tweaked mounting holes
    Ensured mounting holes were concentric with filled zones and correct distance from the edge. also added dimensions
    [Telemetry PCB V2.kicad_pcb]
2025-01-25 Changed lines around holes to ruled zones
    the lines that were used to prevent fills were becoming traces so I changed them to rule zones that prevent anything from entering the zone
    [Telemetry PCB V2.kicad_pcb]
2025-01-28 changed many things
    changed capacitor footprint, moved tx2 and rx2 to a uart pin. moved nrst switch moved j3 header
    [Telemetry PCB V2.kicad_pcb, Telemetry PCB V2.kicad_sch]
2025-02-01 Revamped power, made usb better
    Revamped the layout of the voltage regulator to match closer to the recommend layout form the data sheet.
    Realized I didn't need vias for the usb lines so they are much nicer now
    [Telemetry PCB V2.kicad_pcb, Telemetry PCB V2.kicad_sch]
2025-02-21 Large Board Update
    Changed stack-up order to signal-ground-power-signal2
    tweaked constraints for vias and spacing then adjusted components to fit
    changed stm decoupling capacitors to smaller better placed footprints.
    [Telemetry PCB V2.kicad_pcb, Telemetry PCB V2.kicad_sch]
2025-02-22 Broad tweaks
    Tweaked the location of many power components by small amounts.
    Changed to two 1000uF capacitors foe smoothing
    swapped Flight computer pin header to 3 pin jst-xh
    [Telemetry PCB V2.kicad_pcb, Telemetry PCB V2.kicad_sch]
2025-02-22 added test points
    [Telemetry PCB V2.kicad_pcb, Telemetry PCB V2.kicad_sch]
2025-02-23 :D
    board is done as best I can tell
    This update fully removed the smoothing caps as experienced people don't believe they are necessary. This resulted in moving a couple components around.
    The vias greater than 0.5mm have had solder mask free zones added on them to prevent JLC from trying plug them because JLC says that plugging is likely to fail on large vias.
    [Telemetry PCB V2.kicad_pcb, Telemetry PCB V2.kicad_sch]
2025-03-02 Changed GPS power to 5V
    Changed GPS power to 5V because I was not sure what it's current draw is and we don't have a ton of spare capacity on the 3.3V power regulator. Powering of of 5V is also likely more power efficient as it is not passing through a linear voltage regulator
    [Telemetry PCB V2.kicad_pcb, Telemetry PCB V2.kicad_sch]
2025-03-07 Production files generated
    one via and a single silkscreen tweaked to fit jlcpcb rules. All production files generated following jlcpcb guidelines
    [Telemetry PCB V2-B_Cu.gbl, Telemetry PCB V2-B_Mask.gbs, Telemetry PCB V2-B_Paste.gbp, Telemetry PCB V2-B_Silkscreen.gbo, Telemetry PCB V2-Edge_Cuts.gm1, Telemetry PCB V2-F_Cu.gtl, Telemetry PCB V2-F_Mask.gts, Telemetry PCB V2-F_Paste.gtp]
2025-06-09 Changed schematic to reflect issues found, started to modify board layout.
    [Telemetry PCB V2.kicad_pcb, Telemetry PCB V2.kicad_sch]
2025-06-10 Finished updating board to reflect issues and new components
    [Telemetry PCB V2.kicad_pcb, Telemetry PCB V2.kicad_sch]
2025-06-10 Started adding labels
    [Telemetry PCB V2.kicad_pcb]
2025-06-11 Finished adding labels, fixed DRC violations
    [Telemetry PCB V2.kicad_pcb]
2025-06-13 Moved some components
    [Telemetry PCB V2.kicad_pcb]
2025-06-13 Fixed Fill Zones
    [Telemetry PCB V2.kicad_pcb]
2025-06-20 Generated Gerber files
    Generated Gerber files and drill files and drill map
    [Telemetry PCB V2-B_Cu.gbl, Telemetry PCB V2-B_Mask.gbs, Telemetry PCB V2-B_Paste.gbp, Telemetry PCB V2-B_Silkscreen.gbo, Telemetry PCB V2-Edge_Cuts.gm1, Telemetry PCB V2-F_Cu.gtl, Telemetry PCB V2-F_Mask.gts, Telemetry PCB V2-F_Paste.gtp]
2025-07-08 Version 2.1
    This Is the second board revision and the one that will be launched at LC 2025
    There is an incorrect Pinout for the transmitter module It has been clearly marked on the Fab layer
    The Boards have been modified after manufacturing.
    [Telemetry PCB V2.kicad_pcb]
2025-07-08 V 2.2 Updated Incorrect Pinout
    The Transmitter pinout has been corrected.
    Disregard previous message this will be The flight revision of the board.
    [E22-900M22S.step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]
2025-07-13 Moved Debug Header Slightly
    Moved Debug Header Slightly to accommodate buzzer better
    [Telemetry PCB V2.kicad_pcb]
2025-07-21 Added buzzer header
    [Telemetry PCB V2.kicad_pcb, Telemetry PCB V2.kicad_sch]
2025-07-25 Added Graphics
    [Telemetry PCB V2.kicad_pcb, Telemetry PCB V2.kicad_sch]
2025-07-25 Generated production files
    [Telemetry PCB V2-B_Cu.gbl, Telemetry PCB V2-B_Mask.gbs, Telemetry PCB V2-B_Paste.gbp, Telemetry PCB V2-B_Silkscreen.gbo, Telemetry PCB V2-Edge_Cuts.gm1, Telemetry PCB V2-F_Cu.gtl, Telemetry PCB V2-F_Mask.gts, Telemetry PCB V2-F_Paste.gtp]
2025-08-26 Initial Sending Pebble Commit and Schematic V1
    [Sending Pebble.kicad_pcb, Sending Pebble.kicad_sch]
2025-08-26 Finished Footprint Assignment
    [Sending Pebble.kicad_sch]
2025-08-27 Started Layout, Added DRC
    [Sending Pebble.kicad_pcb, Sending Pebble.kicad_sch]
2025-08-28 Power Circuitry almost finished
    [Sending Pebble.kicad_pcb, Sending Pebble.kicad_sch]
2025-08-31 Updated DRC Rules
    [Sending Pebble.kicad_pcb]
2025-08-31 Finalized form factor, added coplanar waveguides for feedlines and placed all components on board
    [Sending Pebble.kicad_pcb, Sending Pebble.kicad_sch]
2025-08-31 More layout and trace routing
    [Sending Pebble.kicad_pcb]
2025-09-01 Fixed VREG type, more routing
    [LQH3NPN2R2MMEL.step, Sending Pebble.kicad_pcb, Sending Pebble.kicad_sch]
2025-09-02 More routing, added FC connection
    [Sending Pebble-B_Cu.gbr, Sending Pebble-B_Mask.gbr, Sending Pebble-B_Paste.gbr, Sending Pebble-B_Silkscreen.gbr, Sending Pebble-Edge_Cuts.gbr, Sending Pebble-F_Cu.gbr, Sending Pebble-F_Mask.gbr, Sending Pebble-F_Paste.gbr]
2025-09-19 More routing, added amplifier connector, fixed coplanar waveguide. Started adding graphics
    [Sending Pebble.kicad_pcb, Sending Pebble.kicad_sch]
2025-09-22 Finished RF design, added finished graphics, added pin labels
    [Sending Pebble.kicad_pcb]
2025-10-25 Final Changes, Fab files generated
    [Sending Pebble-B_Cu.gbr, Sending Pebble-B_Mask.gbr, Sending Pebble-B_Paste.gbr, Sending Pebble-B_Silkscreen.gbr, Sending Pebble-Edge_Cuts.gbr, Sending Pebble-F_Cu.gbr, Sending Pebble-F_Mask.gbr, Sending Pebble-F_Paste.gbr]
